vv258/PIC-and-Pi-Interface/DOCS/INTERFACE SPECIFICATIONS v6.xlsx

Peripheral | Operation | RASPBERRY Pi to PIC |  |  |  |  |  |  | PIC to RASPBERRY Pi
 |  | BYTE1 (start of Command) | BYTE2(command code) | BYTE3 (Upper 4 bit addr) | BYTE4 (lower 4 bit addr) | BYTE5 | BYTE6 | BYTE7 | BYTE1 | BYTE2 | BYTE3 | BYTE4
 | Handshake | SOT | 0x1A | EOT |  |  |  |  | SOT | 0x1B | EOT
Expanded I/O | Read input | SOT | 0x2A | CHECKSUM | EOT |  |  |  | SOT | 0x2A | 0000,1 bit for each MSB I/O; 1- high, 0- low | 0000, 1 bit for each LSB I/O; 1- high, 0- low
 | write output | SOT | 0x2B | 0000, 1 bit for each MSB I/O; 1- set HIGH 0- set LOW | 0000, 1 bit for each LSB I/O; 1- set HIGH 0- set LOW | CHECKSUM | EOT |  | SOT | 0x2B | EOT
DAC | Set Value for CHA | SOT | 0x3A | 00,6 bit MSB value | 00, 6bit LSB value | CHECKSUM | EOT |  | SOT | 0x3A | EOT
 | Set Value for CHB | SOT | 0x3B | 00,6 bit MSB value | 00, 6bit LSB value | CHECKSUM | EOT |  | SOT | 0x3B | EOT
 | ConfigDACA | SOT | 0x3C | 000000,Buffer A number | 000000, MODE | CheckSUM | EOT
 | ConfigDACB | SOT | 0x3D | 000000,Buffer B number | 000000, MODE | CheckSUM | EOT
 | ConfigDACA&B | SOT | 0x3E | 0000Buffer A number,Buffer B number | 000000, MODE | CheckSUM | EOT
 | Start DAC | SOT | 0x3F | 00, 6 bits for prescaler | 000, 5 bits for higher #of buffer samples | 000, 5 bits for lower #of buffer samples | CHECKSUM | EOT
 | Stop DAC | SOT | 0X39 | CheckSUM | EOT
ADC | Check Buffer Status | SOT | 0x4A | CHECKSUM | EOT |  |  |  | SOT | 0x4A | 0000, 1bit for each of four buffers, 1- ready, 0 -not ready | EOT
 | Set Sample Frequency | SOT | 0x4B | 00, 6 bits for prescaler | 000, 5 bits for higher #of buffer samples | 000, 5 bits for lower #of buffer samples | CHECKSUM | EOT | SOT | 0x4B | EOT
 | Start ADC | SOT | 0x4C | 00, 4 bits: select analog channel, 2 bits:buffer selections | CHECKSUM | EOT |  |  | SOT | 0x4C | EOT
 |  |  |  | 6 bits | 5 bits | 5 bits
PWM | Set Period | SOT | 0x5A | 000,time period | 000,time period | CHECKSUM | EOT |  | SOT | 0x5A | EOT
 | Generate PWM 1 | SOT | 0x5B | 000,on time | 000,on time | CHECKSUM | EOT |  | SOT | 0x5B | EOT
 | Generate PWM 2 | SOT | 0x5C | 000,on time | 000,on time | CHECKSUM | EOT |  | SOT | 0x5C | EOT
Memory | Read Buffer | SOT | 0x6A | 000000,Buffer number | 000, 5 bits for higher #of buffer samples | 000, 5 bits for lower #of buffer samples | CHECKSUM | EOT | SOT | 0x6A | EOT | followed by DMA burst
 | Write Buffer | SOT | 0x6B | 000000,Buffer number | 000, 5 bits for higher #of buffer samples | 000, 5 bits for lower #of buffer samples | CHECKSUM | EOT | SOT | 0x6B | EOT | followed by DMA burst | 0x3A as Byte ACK for every 8th received Byte
 |  |  |  |  |  |  |  |  | SOT | RECEIVED CMD CODE | ERROR STATUS | EOT
 |  | SOT | F0 | START OF TRANSMIT
 |  | EOT | D7 | END OF TRANSMIT
 |  | STATUS | 0X13 | ACK
 |  |  | 0X4A | INVALID COMMAND CODE
 |  |  | 0X7B | CHECKSUM ERROR
