vv258/PIC-and-Pi-Interface/SCH/BOTTOM.PNG

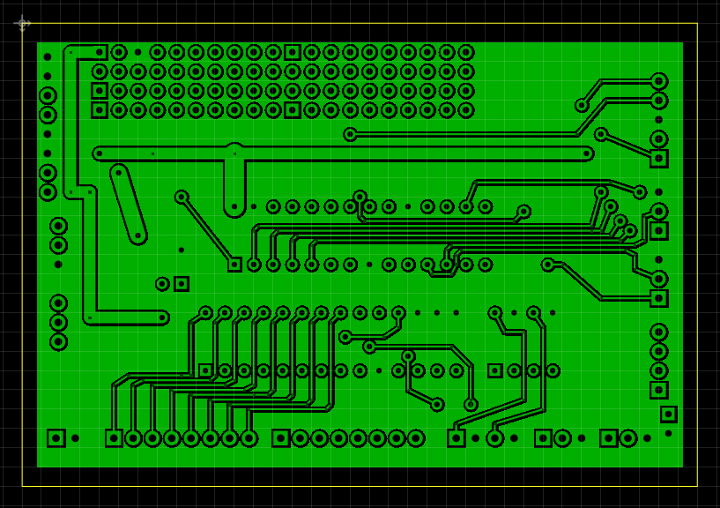
SCH/BOTTOM.PNG
