vv258/PIC-and-Pi-Interface/SCH/COMBINED.PNG

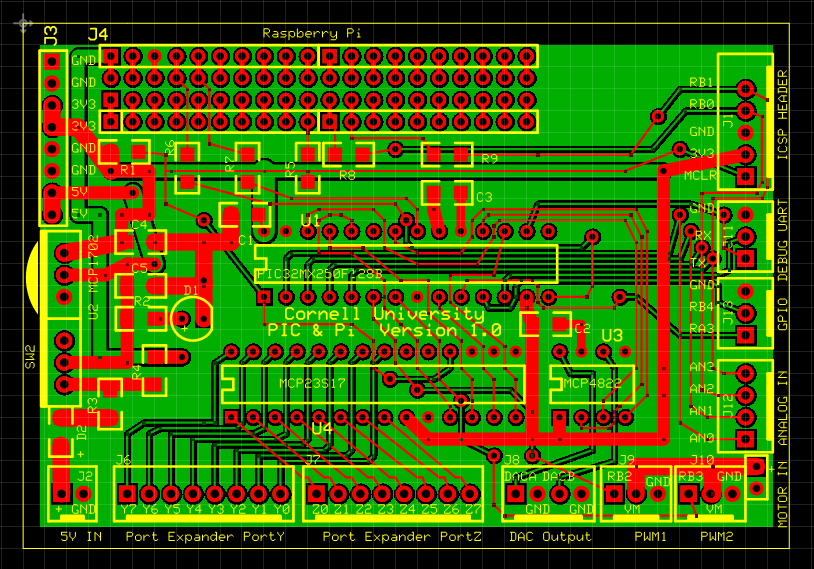
SCH/COMBINED.PNG
