vv258/PIC-and-Pi-Interface/SCH/dev_board_v2.bmp

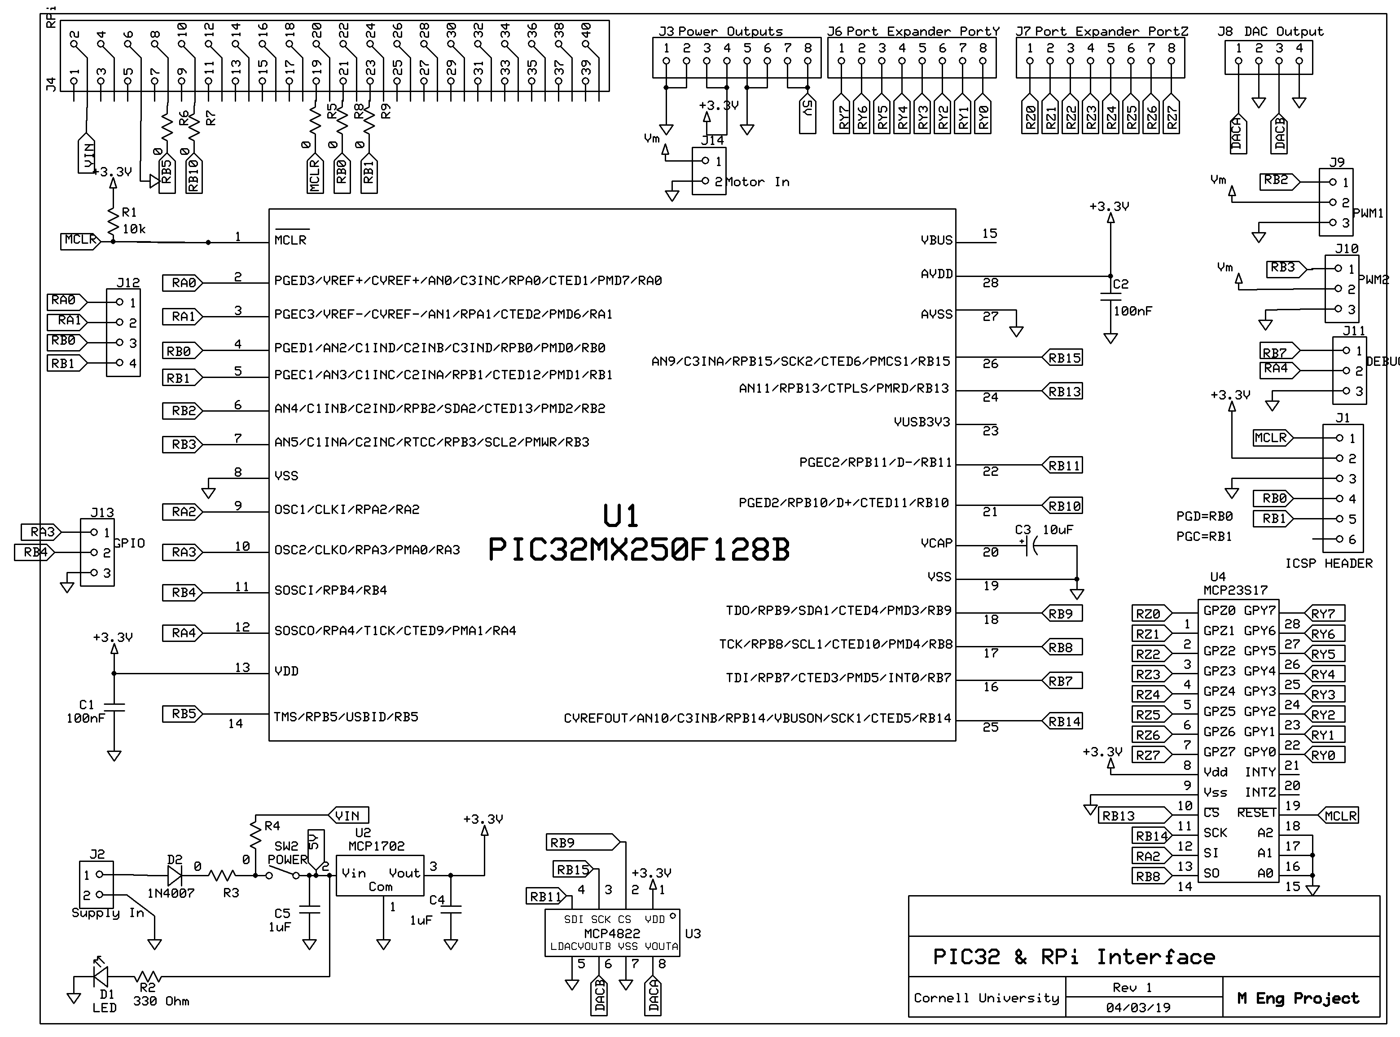
SCH/dev_board_v2.bmp
