vv258/PIC-and-Pi-Interface/SCH/GA.PNG

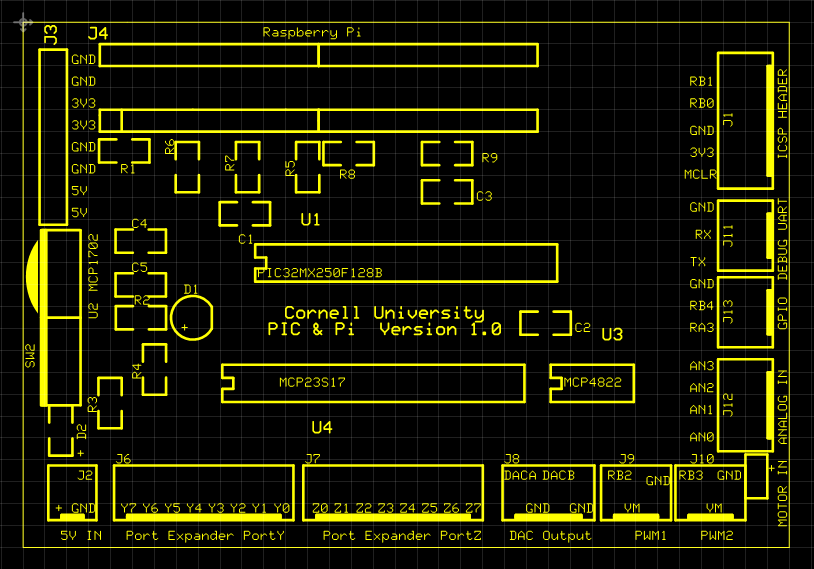
SCH/GA.PNG
