vv258/PIC-and-Pi-Interface/SCH/TOP.PNG

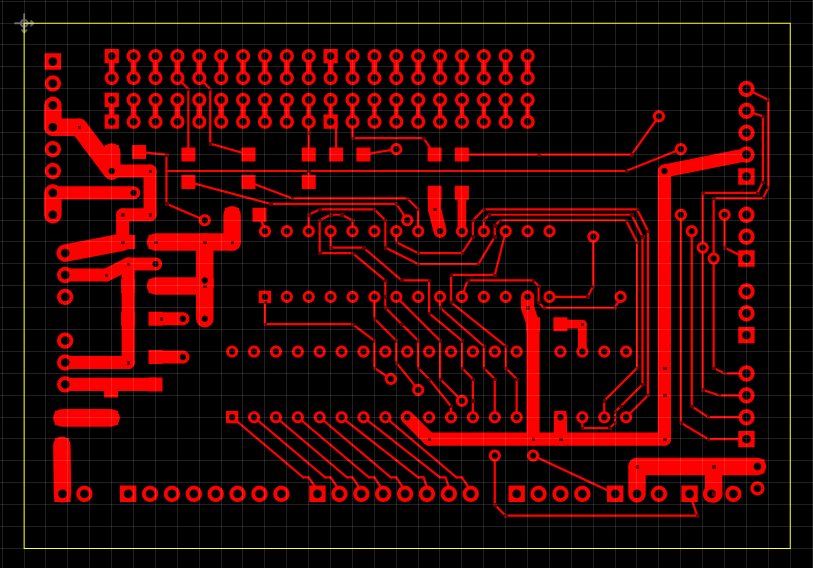
SCH/TOP.PNG
