vv258/PIC-and-Pi-Interface/SCH/bom.xlsx

Sl no | Reference | Description | Remarks
1 | C1, C2 | 100nF
2 | C3 | 10uF
3 | C4, C5 | 1uF
4 | D1 | LED
5 | D2 | 1N4007
6 | J1-J4,J6-J14 | Right angle male headers | ICSP HEADER
7 | R1 | 10k
8 | R2 | 330 Ohm
9 | R3(#) | 0 | Mount for powering PIC from external supply
10 | R4(# $) | 0 | Mount for powering PIC from RPi
11 | R6, R7 | 0
12 | R5,R8,R9(*) | 0 | Mount for programming from Pi
13 | SW2 | POWER
14 | U1 | PIC32MX250F128B
15 | U2 | MCP1702
16 | U3 | MCP4822
17 | U4 | MCP23S17
 | # Do not mount R3 and R4 at the same time
 | $ Not tested yet. RPi may not be able to supply sufficient power
 | * Not tested yet
