vv258/PIC-and-Pi-Interface/SCH/schem.pdf

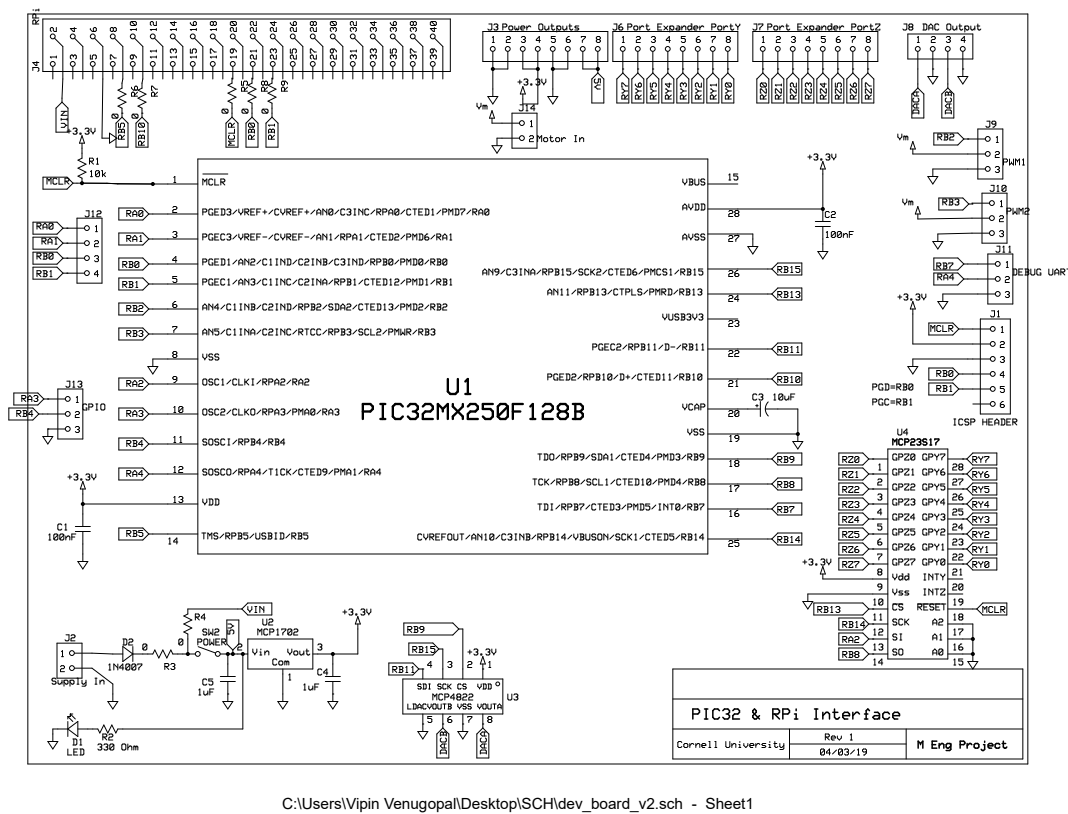
[picture p7: page 1]

C:\Users\Vipin Venugopal\Desktop\SCH\dev_board_v2.sch - Sheet1
