vv258/PIC-and-Pi-Interface/(commit log)

2019-03-17 spi tested adc 2 channel static ok
2019-05-11 Post demo
    [INTERFACE SPECIFICATIONS v6.xlsx, bom.xlsx, dev_board_v2.sch, function definitions.xlsx]
